Haaremy/hmyLaser32/public/papers/v1/LCD1602.jpg

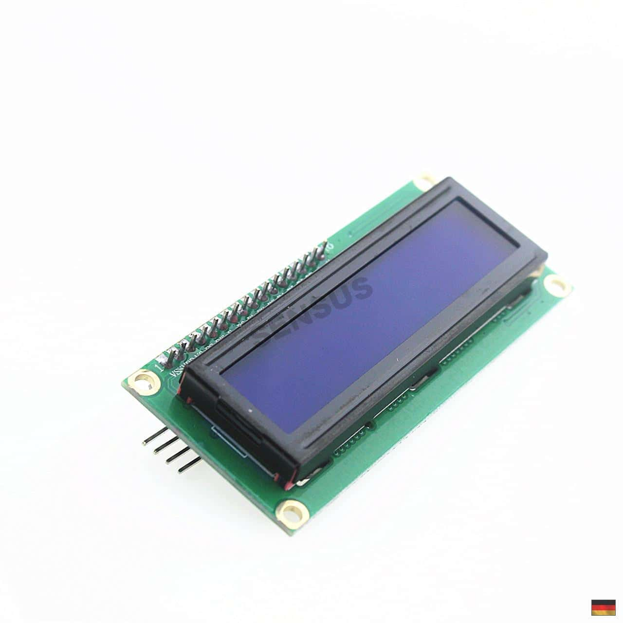
public/papers/v1/LCD1602.jpg
