Haaremy/hmyLaser32/public/papers/v1/Konzept_Pistole.jpg

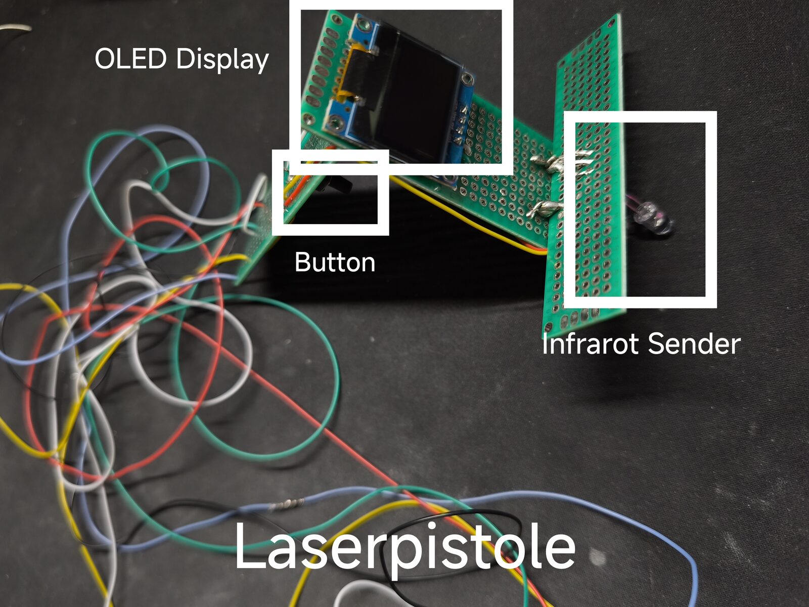
public/papers/v1/Konzept_Pistole.jpg
