Haaremy/hmyLaser32/public/papers/v1/ESP32_Dev_Board.jpg

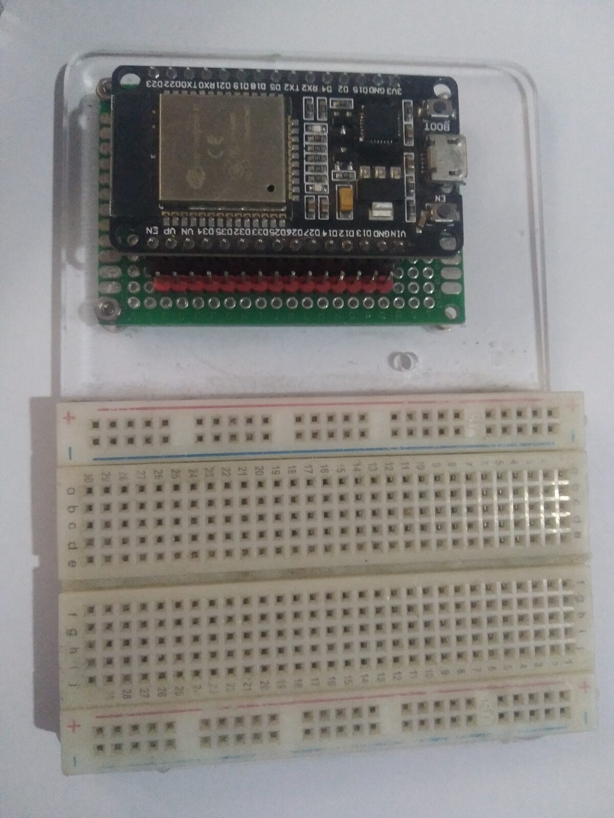
public/papers/v1/ESP32_Dev_Board.jpg
