Haaremy/hmyLaser32/public/papers/v1/Konzept-Weste.jpg

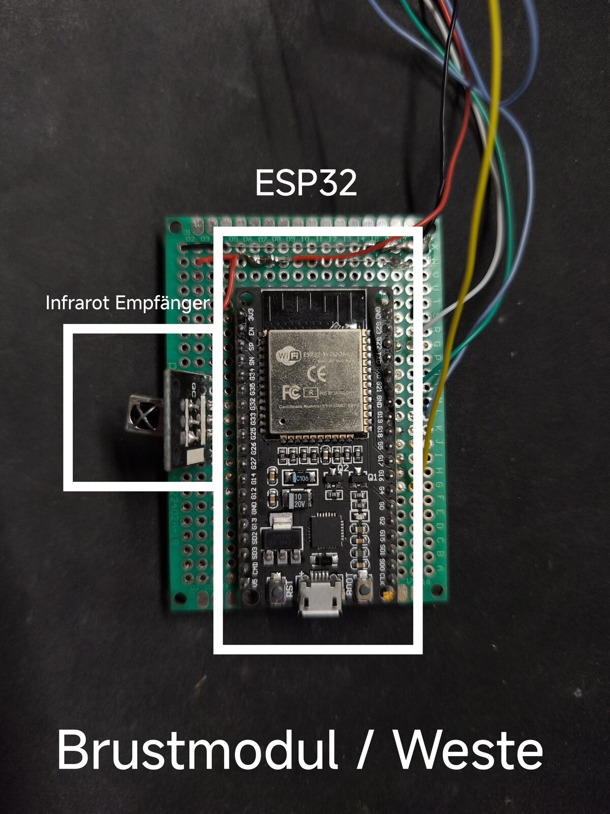
public/papers/v1/Konzept-Weste.jpg
