Haaremy/hmyLaser32/public/papers/v1/KY_Infrarot_Set.jpg

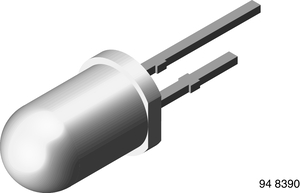
public/papers/v1/KY_Infrarot_Set.jpg
