Haaremy/hmyLaser32/public/papers/v1/TSOP38238.jpg

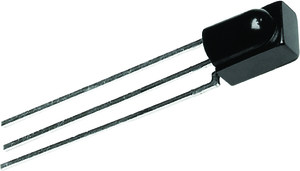
public/papers/v1/TSOP38238.jpg
