Haaremy/hmyLaser32/Arduino/lasertag_client/Game.cpp

#include "Game.h"
#include <IRutils.h>
#include <cstring>
#include "Config.h"
#include "Display.h"
#include "Globals.h"
#include "Identity.h"
#include "Led.h"
#include "LasertagNetwork.h"
#include "Ranking.h"
#include "ZoneIr.h"

uint32_t getMyPlayerId() {
  return irsend.encodeNEC(IR_GAME_ADDRESS, identityMyCommand());
}

static uint8_t reverse8(uint8_t value) {
  value = (value & 0xF0) >> 4 | (value & 0x0F) << 4;
  value = (value & 0xCC) >> 2 | (value & 0x33) << 2;
  value = (value & 0xAA) >> 1 | (value & 0x55) << 1;
  return value;
}

static uint8_t commandFromPlayerId(uint32_t playerId) {
  return reverse8((uint8_t)((playerId >> 8) & 0xFFu));
}

bool isPlayerDisabled() {
  return static_cast<long>(playerDisabledUntil - millis()) > 0;
}

unsigned long getDisableTimeLeftMs() {
  if (!isPlayerDisabled()) return 0;
  return playerDisabledUntil - millis();
}

static uint8_t effectivePhase() {
  if (g_phaseLastUpdate != 0 && (millis() - g_phaseLastUpdate) < PHASE_TIMEOUT_MS) {
    if (g_phase == PHASE_IDLE) return PHASE_ACTIVE;
    return g_phase;
  }
  if (g_standalonePhase != PHASE_IDLE) return g_standalonePhase;
  return PHASE_ACTIVE;
}

bool isShootingAllowed() {
  return effectivePhase() == PHASE_ACTIVE;
}

static uint32_t resolveShooterColor(uint32_t shooterPlayerId) {
  uint8_t cmd = commandFromPlayerId(shooterPlayerId);
  bool teamsFresh = g_teamCount > 0 && (millis() - g_teamsLastUpdate) < TEAMS_TIMEOUT_MS;
  if (teamsFresh) {
    uint32_t bit = (cmd >= 1 && cmd <= 32) ? (1u << (cmd - 1)) : 0u;
    for (uint8_t i = 0; i < g_teamCount; i++) {
      if (g_teams[i].memberBits & bit) return g_teams[i].color;
    }
  }
  if (cmd >= 1) return COLOR_POOL[(cmd - 1) % COLOR_POOL_SIZE];
  return 0xFFFFFF;
}

bool handleTrigger() {
  bool reading = digitalRead(BUTTON_PIN);

  if (reading != lastRawButtonReading) {
    lastDebounce = millis();
    lastRawButtonReading = reading;
  }

  if ((millis() - lastDebounce) > DEBOUNCE_MS && reading != lastButtonState) {
    lastButtonState = reading;

    if (reading == LOW) {
      if (isPlayerDisabled()) { updateDisplay(); return true; }
      if (!isShootingAllowed()) { updateDisplay(); return true; }
      if (!identityIsAssigned()) { updateDisplay(); return true; }

      const uint32_t myPlayerId = getMyPlayerId();
      irsend.sendNEC(static_cast<uint64_t>(myPlayerId), 32);
      lastShotAt = millis();
      shotsFired++;
      Serial.printf("[SHOT] %s sent NEC 0x%lx, shot #%d\n",
                    identityMyName(), (unsigned long)myPlayerId, shotsFired);
      broadcastPlayerState();
      updateDisplay();
    }
  }
  return true;
}

static void resetHitCounters() {
  hitCount = 0;
  hitCountPrimary = 0;
  hitCountSecondary = 0;
  hitCountTertiary = 0;
}

static int teamIndexForPlayer(uint32_t playerId) {
  uint8_t cmd = commandFromPlayerId(playerId);
  bool teamsFresh = g_teamCount > 0 && (millis() - g_teamsLastUpdate) < TEAMS_TIMEOUT_MS;
  if (!teamsFresh) return -1;
  uint32_t bit = (cmd >= 1 && cmd <= 32) ? (1u << (cmd - 1)) : 0u;
  if (!bit) return -1;
  for (uint8_t i = 0; i < g_teamCount; i++) {
    if (g_teams[i].memberBits & bit) return i;
  }
  return -1;
}

static bool isFriendlyFire(uint32_t shooterPlayerId) {
  if (strcmp(g_phaseMode, "team") != 0) return false;
  int shooterTeam = teamIndexForPlayer(shooterPlayerId);
  int myTeam = teamIndexForPlayer(getMyPlayerId());
  return shooterTeam >= 0 && myTeam >= 0 && shooterTeam == myTeam;
}

static uint16_t encodedAddressPrefix() {
  return (uint16_t)((irsend.encodeNEC(IR_GAME_ADDRESS, 0) >> 16) & 0xFFFFu);
}

static bool isValidGameNec(uint32_t raw) {
  const uint16_t addressPrefix = (uint16_t)((raw >> 16) & 0xFFFFu);
  const uint8_t encodedCommand = (uint8_t)((raw >> 8) & 0xFFu);
  const uint8_t encodedCommandInverse = (uint8_t)(raw & 0xFFu);
  return addressPrefix == encodedAddressPrefix() &&
         (uint8_t)(encodedCommand ^ encodedCommandInverse) == 0xFFu;
}

static const char *zoneName(uint8_t zone) {
  switch (zone) {
    case 1: return "ZONE1";
    case 2: return "ZONE2";
    case 3: return "ZONE3";
    default: return "ZONE?";
  }
}

static int zonePointsForFrame(const ZoneIrFrame &frame) {
  if (frame.zone >= 1 && frame.zone <= 3) return g_zonePoints[frame.zone - 1];
  return 0;
}

static bool shouldPreferFrame(const ZoneIrFrame &candidate, const ZoneIrFrame &selected) {
  const int candidatePoints = zonePointsForFrame(candidate);
  const int selectedPoints = zonePointsForFrame(selected);
  if (candidatePoints != selectedPoints) return candidatePoints > selectedPoints;
  return (int32_t)(candidate.startUs - selected.startUs) < 0;
}

static bool handleIrZoneFrame(uint32_t shooterId,
                              const char *sensorName,
                              int &sensorHitCount,
                              int zonePoints) {
  const char *shooterName = findPlayerNameById(shooterId);
  char shooterNameCopy[12] = {};
  const bool withinSelfHitWindow = millis() - lastShotAt < SELF_HIT_IGNORE_MS;
  if (shooterName) {
    strncpy(shooterNameCopy, shooterName, sizeof(shooterNameCopy) - 1);
    shooterNameCopy[sizeof(shooterNameCopy) - 1] = '\0';
  } else {
    uint8_t cmd = commandFromPlayerId(shooterId);
    snprintf(shooterNameCopy, sizeof(shooterNameCopy), "Cmd%03u", (unsigned)cmd);
  }

  if (!isValidGameNec(shooterId)) {
    Serial.printf("[IR:%s] ignored raw=0x%08lx expectedPrefix=0x%04x\n",
                  sensorName,
                  (unsigned long)shooterId,
                  (unsigned)encodedAddressPrefix());
  } else if (isPlayerDisabled()) {
    Serial.printf("[IR:%s] ignored while disabled from %s\n", sensorName, shooterNameCopy);
  } else if (!isShootingAllowed()) {
    Serial.printf("[IR:%s] ignored outside ACTIVE phase from %s\n", sensorName, shooterNameCopy);
  } else if (shooterId == getMyPlayerId() && withinSelfHitWindow) {
    Serial.printf("[IR:%s] ignored self reflection from %s\n", sensorName, shooterNameCopy);
  } else if (shooterId != getMyPlayerId() && !isFriendlyFire(shooterId)) {
    hitCount++;
    sensorHitCount++;
    playerDisabledUntil = millis() + HIT_DISABLE_MS;
    uint32_t shooterColor = resolveShooterColor(shooterId);
    triggerHitBlink(shooterColor);
    Serial.printf("[HIT:%s] from %s (color #%06lx, sensor hits %d/%d/%d, +%d)\n",
                  sensorName,
                  shooterNameCopy[0] ? shooterNameCopy : "?",
                  (unsigned long)shooterColor,
                  hitCountPrimary,
                  hitCountSecondary,
                  hitCountTertiary,
                  zonePoints);

    if (awardPointsToPlayer(shooterId, shooterNameCopy, zonePoints)) {
      queueTableBroadcast();
    }
    broadcastHitEvent(shooterId, shooterNameCopy, zonePoints);
    broadcastPlayerState();
    updateDisplay();
  }

  return true;
}

bool handleIrReceiver() {
  ZoneIrFrame frame = {};
  if (isPlayerDisabled()) {
    while (zoneIrPoll(frame)) { }
    return false;
  }

  ZoneIrFrame selected = {};
  bool hasSelected = false;
  while (zoneIrPoll(frame)) {
    if (!isValidGameNec(frame.raw)) {
      Serial.printf("[IR:%s GPIO%u] ignored raw=0x%08lx expectedPrefix=0x%04x\n",
                    zoneName(frame.zone),
                    (unsigned)frame.pin,
                    (unsigned long)frame.raw,
                    (unsigned)encodedAddressPrefix());
      continue;
    }
    Serial.printf("[IR:%s GPIO%u] candidate raw=0x%08lx t=%lu pts=%d\n",
                  zoneName(frame.zone),
                  (unsigned)frame.pin,
                  (unsigned long)frame.raw,
                  (unsigned long)frame.startUs,
                  zonePointsForFrame(frame));
    if (!hasSelected || shouldPreferFrame(frame, selected)) {
      selected = frame;
      hasSelected = true;
    }
  }

  if (!hasSelected) return false;

  if (selected.zone == 1) {
    return handleIrZoneFrame(selected.raw, "ZONE1", hitCountPrimary, g_zonePoints[0]);
  }
  if (selected.zone == 2) {
    return handleIrZoneFrame(selected.raw, "ZONE2", hitCountSecondary, g_zonePoints[1]);
  }
  if (selected.zone == 3) {
    return handleIrZoneFrame(selected.raw, "ZONE3", hitCountTertiary, g_zonePoints[2]);
  }
  return false;
}

void resetRuntimeStatsForNewMatch() {
  shotsFired = 0;
  myPoints = 0;
  resetHitCounters();
}

void updateRespawnDisplayState(bool disabledNow, bool &wasPlayerDisabled) {
  if (disabledNow) {
    if (millis() - lastDisplayRefreshAt >= 150) updateDisplay();
  } else if (wasPlayerDisabled) {
    applyTeamColor();
    updateDisplay();
  }
  wasPlayerDisabled = disabledNow;
}

// === Standalone-State-Machine (v4 + v4.1 Master-Election) ================
// Master (= niedrigste MAC unter den bekannten Peers) treibt die State-
// Machine voran. Andere Clients syncen ihre Timer per MSG_STANDALONE.
//
// Wenn länger als STANDALONE_TIMEOUT_MS keine Master-Nachricht eingegangen
// ist, übernimmt der aktuelle Knoten (sofern er Master ist) selbst die
// Initiative — oder bleibt im aktuellen Zustand bis der Master wieder da
// ist (passive Knoten).
static unsigned long kStandaloneStateChangedAt = 0;

void standaloneStateTick(int peerCountIncludingSelf) {
  bool serverActive = (g_phaseLastUpdate != 0 && (millis() - g_phaseLastUpdate) < PHASE_TIMEOUT_MS);
  if (serverActive) {
    g_standalonePhase = PHASE_IDLE;
    return;
  }
  if (!identityIsAssigned()) return;

  unsigned long now = millis();
  bool iAmMaster = identityIsLobbyMaster();
  bool masterFresh = (g_standaloneLastUpdate != 0) &&
                     (now - g_standaloneLastUpdate < STANDALONE_TIMEOUT_MS);

  // Wenn ein Master existiert und nicht ich bin → passive: warten auf
  // MSG_STANDALONE, lokale Timer werden durch handleStandalone() gesetzt.
  // Wenn der lokal aktive Phasenstand abgelaufen ist, einfach Timer-Update
  // dem Master überlassen.
  if (!iAmMaster && masterFresh) {
    // Lokal nichts ausrichten — Master treibt voran
    return;
  }

  // Ich bin Master ODER kein frischer Master da → ich entscheide
  switch (g_standalonePhase) {
    case PHASE_IDLE:
      if (peerCountIncludingSelf >= 2 && iAmMaster) {
        g_standalonePhase = PHASE_LOBBY;
        g_standaloneLobbyEnds = now + STANDALONE_LOBBY_SECONDS * 1000UL;
        kStandaloneStateChangedAt = now;
        Serial.printf("[STANDALONE] Master starts LOBBY (%lus)\n",
                      (unsigned long)STANDALONE_LOBBY_SECONDS);
        memset(ranking, 0, sizeof(ranking));
        resetRuntimeStatsForNewMatch();
        updateDisplay();
      }
      break;
    case PHASE_LOBBY:
      if ((long)(now - g_standaloneLobbyEnds) >= 0 && iAmMaster) {
        g_standalonePhase = PHASE_ACTIVE;
        g_standaloneMatchEnds = now + STANDALONE_MATCH_SECONDS * 1000UL;
        kStandaloneStateChangedAt = now;
        Serial.printf("[STANDALONE] Master moves to ACTIVE (%lus)\n",
                      (unsigned long)STANDALONE_MATCH_SECONDS);
        updateDisplay();
      }
      break;
    case PHASE_ACTIVE:
      if ((long)(now - g_standaloneMatchEnds) >= 0 && iAmMaster) {
        g_standalonePhase = PHASE_DONE;
        kStandaloneStateChangedAt = now;
        Serial.println("[STANDALONE] Master moves to DONE");
        updateDisplay();
      }
      break;
    case PHASE_DONE:
      if (now - kStandaloneStateChangedAt > 15000UL && iAmMaster) {
        g_standalonePhase = PHASE_IDLE;
        kStandaloneStateChangedAt = now;
        updateDisplay();
      }
      break;
  }
}
