Haaremy/hmyLaser32/Arduino/lasertag_client/Network.cpp

#include <WiFi.h>
#include <cstring>
#include "Config.h"
#include "Display.h"
#include "Game.h"
#include "Globals.h"
#include "Identity.h"
#include "LasertagNetwork.h"
#include "Led.h"
#include "Nfc.h"
#include "Ranking.h"

bool peerExists(const uint8_t *mac) {
  for (int i = 0; i < peerCount; i++) {
    if (memcmp(knownPeers[i], mac, 6) == 0) return true;
  }
  return false;
}

void addPeer(const uint8_t *mac) {
  if (peerExists(mac) || peerCount >= MAX_PEERS) return;
  esp_now_peer_info_t peerInfo = {};
  memcpy(peerInfo.peer_addr, mac, 6);
  peerInfo.channel = 0;
  peerInfo.encrypt = false;
  if (esp_now_add_peer(&peerInfo) == ESP_OK) {
    memcpy(knownPeers[peerCount], mac, 6);
    peerCount++;
  }
}

#if defined(ESP_ARDUINO_VERSION_MAJOR) && ESP_ARDUINO_VERSION_MAJOR >= 3
void onDataSent(const wifi_tx_info_t *info, esp_now_send_status_t status) {
  (void)info; lastSendStatus = status; sendStatusPending = true;
}
#else
void onDataSent(const uint8_t *mac_addr, esp_now_send_status_t status) {
  (void)mac_addr; lastSendStatus = status; sendStatusPending = true;
}
#endif

static void handlePhase(const Message &m) {
  if (m.playerCount < 1) return;
  uint8_t newPhase = (uint8_t)m.entries[0].playerId;
  if (newPhase > PHASE_DONE) return;
  uint8_t prevPhase = g_phase;
  g_phase = newPhase;
  g_phaseSecondsLeft = (uint32_t)(m.entries[0].points < 0 ? 0 : m.entries[0].points);
  if (m.playerCount > 1 && m.entries[1].points > 0) {
    g_zonePoints[0] = m.entries[1].points;
    g_hitPoints = g_zonePoints[0];
  }
  if (m.playerCount > 2 && m.entries[2].points > 0) {
    g_zonePoints[1] = m.entries[2].points;
  }
  if (m.playerCount > 3 && m.entries[3].points > 0) {
    g_zonePoints[2] = m.entries[3].points;
  }
  g_phaseLastUpdate = millis();
  strlcpy(g_phaseMode, m.entries[0].player, sizeof(g_phaseMode));
  if (prevPhase != newPhase) {
    if (newPhase == PHASE_LOBBY) {
      resetRuntimeStatsForNewMatch();
      memset(ranking, 0, sizeof(ranking));
      playerDisabledUntil = 0;
    }
    applyTeamColor();
    updateDisplay();
  }
}

static void handleTeams(const Message &m) {
  g_teamCount = m.playerCount > MAX_TEAMS ? MAX_TEAMS : m.playerCount;
  g_myTeamIndex = -1;
  uint8_t myCmd = identityMyCommand();
  uint32_t myBit = (myCmd >= 1 && myCmd <= 32) ? (1u << (myCmd - 1)) : 0u;
  for (uint8_t i = 0; i < g_teamCount; i++) {
    strlcpy(g_teams[i].name, m.entries[i].player, sizeof(g_teams[i].name));
    g_teams[i].color      = m.entries[i].playerId & 0x00FFFFFFu;
    g_teams[i].memberBits = m.entries[i].lastUpdate;
    if (myBit && (g_teams[i].memberBits & myBit)) g_myTeamIndex = (int8_t)i;
  }
  g_teamsLastUpdate = millis();
  applyTeamColor();
  updateDisplay();
}

// v4.1: MSG_STANDALONE vom Lobby-Master.
// entries[0].playerId   = phase
// entries[0].points     = secondsLeftInPhase
// entries[0].player     = "standalone"
// entries[0].lastUpdate = millis() (Sender-Clock)
static void handleStandalone(const Message &m, const uint8_t *srcMac) {
  if (m.playerCount < 1) return;
  uint8_t newPhase = (uint8_t)m.entries[0].playerId;
  if (newPhase > PHASE_DONE) return;
  unsigned long secsLeft = (uint32_t)(m.entries[0].points < 0 ? 0 : m.entries[0].points);
  unsigned long now = millis();

  uint8_t prevPhase = g_standalonePhase;
  g_standalonePhase = newPhase;
  g_standaloneLastUpdate = now;

  if (newPhase == PHASE_LOBBY) {
    g_standaloneLobbyEnds = now + secsLeft * 1000UL;
  } else if (newPhase == PHASE_ACTIVE) {
    g_standaloneMatchEnds = now + secsLeft * 1000UL;
  }

  if (prevPhase != newPhase) {
    Serial.printf("[STANDALONE] Synced from master: phase %u -> %u (%lu s left)\n",
                  prevPhase, newPhase, secsLeft);
    if (newPhase == PHASE_LOBBY) {
      resetRuntimeStatsForNewMatch();
      memset(ranking, 0, sizeof(ranking));
    }
    applyTeamColor();
    updateDisplay();
  }
}

static void handlePlayerConfig(const Message &m) {
  uint32_t myId = getMyPlayerId();
  uint8_t myCmd = identityMyCommand();
  for (int i = 0; i < m.playerCount && i < MAX_PLAYERS; i++) {
    const RankingEntry &e = m.entries[i];
    if (e.playerId != myId) continue;
    uint32_t color = e.lastUpdate & 0x00FFFFFFu;
    if (color != 0) {
      g_myAssignedColor = color;
      identitySetColor(color);
    }
    g_myTeamIndex = (int8_t)e.points;
    if (e.player[0] != '\0' && !nfcIsBound()) identitySetName(e.player);
    Serial.printf("[CONFIG] cmd=%u team=%d color=#%06lx name=%s\n",
                  (unsigned)myCmd, (int)g_myTeamIndex, (unsigned long)color, identityMyName());
    broadcastPlayerState();
    return;
  }
}

static bool mergeRankingEntries(const Message &m) {
  bool changed = false;
  for (int i = 0; i < m.playerCount && i < MAX_PLAYERS; i++) {
    if (m.entries[i].player[0] == '\0') continue;
    if (upsertRankingEntry(m.entries[i].playerId,
                           m.entries[i].player,
                           m.entries[i].points,
                           m.entries[i].lastUpdate)) changed = true;
  }
  if (changed) {
    syncMyPointsFromRanking();
    updateDisplay();
  }
  return changed;
}

void processIncomingMessage(const uint8_t *srcAddr, const uint8_t *data, int len) {
  if (len != sizeof(Message)) return;
  Message incoming;
  memcpy(&incoming, data, sizeof(incoming));
  addPeer(srcAddr);

  bool isServer = (incoming.msgType == MSG_PHASE || incoming.msgType == MSG_TEAMS);
  identityPeerSeen(srcAddr, isServer);

  switch (incoming.msgType) {
    case MSG_DISCOVERY:
      mergeRankingEntries(incoming);
      queueTableBroadcast();
      return;
    case MSG_PHASE:
      handlePhase(incoming);
      return;
    case MSG_TEAMS:
      handleTeams(incoming);
      return;
    case MSG_PLAYER_CONFIG:
      handlePlayerConfig(incoming);
      return;
    case MSG_STANDALONE:
      handleStandalone(incoming, srcAddr);
      return;
    case MSG_NFC:
      return;
    case MSG_TABLE: {
      if (mergeRankingEntries(incoming)) {
        queueTableBroadcast();
      }
      return;
    }
    default:
      return;
  }
}

#if defined(ESP_ARDUINO_VERSION_MAJOR) && ESP_ARDUINO_VERSION_MAJOR >= 2
void onDataRecv(const esp_now_recv_info_t *info, const uint8_t *data, int len) {
  processIncomingMessage(info->src_addr, data, len);
}
#else
void onDataRecv(const uint8_t *mac, const uint8_t *data, int len) {
  processIncomingMessage(mac, data, len);
}
#endif

void sendDiscovery() {
  const uint8_t broadcast[] = {0xFF, 0xFF, 0xFF, 0xFF, 0xFF, 0xFF};
  memset(&outgoing, 0, sizeof(outgoing));
  strncpy(outgoing.senderName, identityMyName(), sizeof(outgoing.senderName) - 1);
  outgoing.msgType = MSG_DISCOVERY;
  if (identityIsAssigned()) {
    outgoing.playerCount = 1;
    outgoing.entries[0].playerId = getMyPlayerId();
    strncpy(outgoing.entries[0].player, identityMyName(), sizeof(outgoing.entries[0].player) - 1);
    outgoing.entries[0].points = myPoints;
    outgoing.entries[0].lastUpdate = millis();
  } else {
    outgoing.playerCount = 0;
  }
  esp_now_send(broadcast, reinterpret_cast<const uint8_t *>(&outgoing), sizeof(outgoing));
}

void broadcastRankingTable() {
  const uint8_t broadcast[] = {0xFF, 0xFF, 0xFF, 0xFF, 0xFF, 0xFF};
  memset(&outgoing, 0, sizeof(outgoing));
  strncpy(outgoing.senderName, identityMyName(), sizeof(outgoing.senderName) - 1);
  outgoing.msgType = MSG_TABLE;
  for (int i = 0; i < MAX_PLAYERS; i++) {
    outgoing.entries[i] = ranking[i];
    if (ranking[i].player[0] != '\0') outgoing.playerCount++;
  }
  // Broadcast statt unicast-an-jeden — spart Bandbreite
  esp_now_send(broadcast, reinterpret_cast<const uint8_t *>(&outgoing), sizeof(outgoing));
  lastTableBroadcast = millis();
  pendingTableBroadcast = false;
}

static void copyChunk(char *dst, size_t dstLen, const char *src, int chunk) {
  if (!src || !dst || dstLen == 0) return;
  strncpy(dst, src + (chunk * 11), dstLen - 1);
  dst[dstLen - 1] = '\0';
}

void broadcastPlayerState() {
  if (!identityIsAssigned()) return;
  const uint8_t broadcast[] = {0xFF, 0xFF, 0xFF, 0xFF, 0xFF, 0xFF};
  Message m = {};
  strlcpy(m.senderName, identityMyName(), sizeof(m.senderName));
  m.msgType = MSG_PLAYER_STATE;
  m.playerCount = 6;
  m.entries[0].playerId = getMyPlayerId();
  strlcpy(m.entries[0].player, identityMyName(), sizeof(m.entries[0].player));
  m.entries[0].points = myPoints;
  m.entries[0].lastUpdate = millis();

  m.entries[1].playerId = (g_myAssignedColor ? g_myAssignedColor : identityMyColor()) & 0x00FFFFFFu;
  m.entries[1].points = (int16_t)(shotsFired > 32767 ? 32767 : shotsFired);
  m.entries[1].lastUpdate = (uint32_t)(hitCount > 65535 ? 65535 : hitCount);

  m.entries[2].points = g_myTeamIndex;
  const char *token = nfcLastToken();
  for (int i = 0; i < 4; i++) {
    copyChunk(m.entries[i + 2].player, sizeof(m.entries[i + 2].player), token, i);
  }
  esp_now_send(broadcast, reinterpret_cast<const uint8_t *>(&m), sizeof(m));
}

void broadcastHitEvent(uint32_t shooterId, const char *shooterName, int points) {
  const uint8_t broadcast[] = {0xFF, 0xFF, 0xFF, 0xFF, 0xFF, 0xFF};
  Message m = {};
  strlcpy(m.senderName, identityMyName(), sizeof(m.senderName));
  m.msgType = MSG_HIT_EVENT;
  m.playerCount = 2;
  m.entries[0].playerId = shooterId;
  strlcpy(m.entries[0].player, shooterName, sizeof(m.entries[0].player));
  m.entries[0].points = (int16_t)points;
  m.entries[0].lastUpdate = millis();
  m.entries[1].playerId = getMyPlayerId();
  strlcpy(m.entries[1].player, identityMyName(), sizeof(m.entries[1].player));
  m.entries[1].points = (int16_t)(hitCount > 32767 ? 32767 : hitCount);
  m.entries[1].lastUpdate = (uint32_t)(shotsFired > 65535 ? 65535 : shotsFired);
  esp_now_send(broadcast, reinterpret_cast<const uint8_t *>(&m), sizeof(m));
}

// v4.1 — Master broadcastet aktuelle Standalone-Phase + Restzeit
void broadcastStandaloneState() {
  if (!identityIsLobbyMaster()) return;
  if (g_standalonePhase == PHASE_IDLE) return;

  const uint8_t broadcast[] = {0xFF, 0xFF, 0xFF, 0xFF, 0xFF, 0xFF};
  Message m = {};
  strlcpy(m.senderName, identityMyName(), sizeof(m.senderName));
  m.msgType = MSG_STANDALONE;
  m.playerCount = 1;
  m.entries[0].playerId = (uint32_t)g_standalonePhase;

  unsigned long now = millis();
  long secsLeft = 0;
  if (g_standalonePhase == PHASE_LOBBY) {
    secsLeft = (long)(g_standaloneLobbyEnds - now) / 1000L;
  } else if (g_standalonePhase == PHASE_ACTIVE) {
    secsLeft = (long)(g_standaloneMatchEnds - now) / 1000L;
  }
  if (secsLeft < 0) secsLeft = 0;
  m.entries[0].points = (int16_t)(secsLeft > 32767 ? 32767 : secsLeft);
  strlcpy(m.entries[0].player, "standalone", sizeof(m.entries[0].player));
  m.entries[0].lastUpdate = now;

  esp_now_send(broadcast, reinterpret_cast<const uint8_t *>(&m), sizeof(m));
}

void handleSendStatusLog() {
  if (sendStatusPending) sendStatusPending = false;
}
