Haaremy/hmyLaser32/(commit log)

2026-05-15 Initial portal scaffold — Next.js 14 + Prisma + Bridge API
    - 14 routes: landing, wiki (hardware/architecture/build-guide/components),
    auth (login/register), profile, leaderboard, match detail, admin (users/devices/matches), game panel
    - Prisma schema: User, EspServer, Match, MatchPlayer, Team
    - Auth: argon2 + iron-session, custom (no SSO per spec)
    - ESP32 bridge: POST /api/bridge/{match/start,match/end,hit}, GET /player/:nfcToken, WS /api/bridge/ws
    - i18n DE/EN via next-intl with cookie locale switch
    - hmyDesign tokens v1.0.0 inlined as CSS variables
    - /api/health endpoint, /api/matches/export (CSV/JSON)
    - Footer with legal.haaremy.de/impressum + datenschutz (Haaremy compliance)
    - Docker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
2026-05-15 Pivot v2: ESP self-register + live match view + wiki from paper
    Architecture pivot per CEO feedback:
    ESP self-registration
    - POST /api/bridge/register: ESP generates name+PIN locally and registers itself.
    Returns 201 on first register, 200 on re-register (same name+PIN), 409 on conflict.
    - Bridge auth and match-settings unlock both use the same PIN (single secret per device).
    - Admin device management removed (no admin gate anymore).
    Schema changes
    - EspServer.accessCode → pin (renamed, single source of truth)
    - EspServer.online: bool, EspServer.name unique
    - Match.settings: Json (per-match config)
    - MatchPlayer.shotsFired: int (for accuracy calc)
    - HitEvent model: persisted live-feed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
2026-05-15 Added Arduino Code
    Open lasertag_main
    Edit Settings, especially inbetween devices.
    On Device Upload
    Upload Speed 115200
    Erase all Flash true
    Upload Frequence 40Mhz
2026-05-15 ESPCode und Latex
2026-05-16 v3: ESP-Server firmware (modular) + Wiki restructure + Latex sources restored
    ESP-Server (Arduino/lasertag_server/)
    - New modular Arduino sketch for the bridge ESP32 NodeMCU-32S
    - Modules: Bridge, Config, EspNow, Globals, Identity, Match, Portal, Storage,
    Types, WiFiSetup + lasertag_server.ino (1182 lines total)
    - Self-generated Name+PIN persisted in NVS (Preferences lib)
    - Captive Portal on first boot: WLAN scan, secure list, click-to-select,
    saves SSID+PSK and reboots into STA mode
    - HTTP bridge to laser32.haaremy.de: auto-register on boot, heartbeat
    every 30s, match-start/end orchestration with lobby timer
    - ESP-NOW listener with score-diff detection forwards hits during ACTIVE
    ma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
    [Bridge.cpp, Bridge.h, Config.h, Display.cpp, EspNow.cpp, EspNow.h, Game.cpp]
2026-05-16 v4: hmyDesign overhaul + new IA (Forschung/DIY/Account/Champions)
    Design system
    - Adopt hmyDesign token CSS verbatim (public/hmy/tokens.css)
    - All component classes now use hmy-* BEM-style naming from
    /opt/hmyDesign/components.md: .hmy-btn, .hmy-card, .hmy-tabs,
    .hmy-input, .hmy-alert, .hmy-field
    - Lasertag-specific classes prefixed .hmy-lt-* for clear separation
    - Match view, ESP detail, champions, research, DIY all migrated
    Information architecture overhaul
    - Landing page reduced to ESP server list only (no more quicklinks)
    - Navbar: Server / Forschung / DIY / Champions / Account
    - /research: index card with each paper; download + read-online side-by-side
    - /research/paper-v1: full we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
2026-05-16 v5: server keeps AP permanently + mDNS + phase-aware client + ESP settings via web
    Pain points addressed
    - ESP-server hotspot vanished after STA connect: switched to AP+STA dual-mode
    permanently. Captive portal stays reachable at http://192.168.4.1 even
    after the device joined the home WiFi. mDNS publishes
    http://hmylaser32-<name>.local as a second access path.
    - Web service was missing ESP-side controls: added a Settings tab on
    /esp/[id] with PIN-gated mode/lobby/match editing and a Match-jetzt-
    starten button. The button sets a startRequested flag in the DB; the ESP
    pulls /api/esp/by-pin/settings every 30 s and consumes the flag atomically.
    - Client had no awareness of the new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
    [Bridge.cpp, Bridge.h, Config.h, Display.cpp, EspNow.cpp, EspNow.h, Game.cpp, Game.h]
2026-05-16 v6: team mode + 24h offline cleanup
    Web service
    - Schema: EspServer.teams Json — array of {name, color, members[]}
    - /api/servers cleans up ESPs that have been offline >24 h (deleteMany on
    lastSeen<cutoff or NULL+createdAt<cutoff).
    - /api/esp/[id]/settings accepts mode enum ("free-for-all" | "team") and
    teams[] payload via zod schema (lib/teams.ts).
    - /api/esp/by-pin/settings includes parsed teams in the pull response.
    - /esp/[id] Settings tab: mode dropdown, dynamic team editor with color
    picker, name, member CSV (MY_IR_COMMAND 1..254). Labels renamed:
    Lobby-Sekunden → Starttimer, Match-Sekunden → Runden-Dauer,
    "Match jetzt starten" → "▶ Timer starten".
    ESP server firmw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
2026-05-16 v7: known-clients push + assign-by-dropdown team editor
    ESP-Server firmware
    - New POST /api/bridge/players sent every 30 s with the current
    g_snapshots[] (name + NEC command + playerId + points + lastSeen).
    - bridgePushKnownPlayers extracts the NEC command byte from the 32-bit
    playerId (bits 8..15) so the web UI can match it to MY_IR_COMMAND.
    - Designated-initializer for g_settings (mode/lobby/match + zero teams).
    - README banner updated to v3.
    - Schema: EspServer.knownPlayers Json (list of {name, command, playerId,
    points, lastSeenSec}).
    - /api/bridge/players (Bearer=PIN) persists the snapshot.
    - /api/esp/[id]/players (public GET) returns the snapshot.
    - lib/players.ts sc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
2026-05-16 v8: WebSockets + auto-identity + hit-effect + NFC stubs
    - server.mjs: new WebSocket endpoints
    /api/ws/match/<id> — Browser live state (snapshot push every 1 s while
    there are subscribers; instant push on /api/bridge/hit POST)
    /api/ws/esp/<id> — Browser ESP detail (live snapshot + bi-directional
    write channel: updateSettings / startMatch via WS, PIN-gated)
    - globalThis.wsHub.broadcastMatch/broadcastEsp called from hit/players/
    settings/start API routes so DB mutations push to subscribers immediately.
    - HitEvent persistence now also upserts MatchPlayer aggregates if the bridge
    passes shooterHits/shooterDeaths/shooterShots in the body.
    Browser
    - /match/[id]: r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
2026-05-16 fix(client): Ranking.cpp uses identityMyName() (MY_NAME removed in v4)
    Compile error after the v4 auto-identity refactor:
    Ranking.cpp:94 'MY_NAME' was not declared in this scope
    In v4 MY_NAME was removed from Config.h in favour of the runtime
    identity (Identity.cpp). updateMyScore() still referenced the old
    constant. Now uses identityMyName() and adds the corresponding
    Identity.h include.
    [Ranking.cpp]
2026-05-16 v4.1 client: fix all-Alpha bug, button back to GPIO 19, master-election
    Bugs reported by user with 3 clients in standalone mode:
    - all three displayed as "Alpha" (rank -1)
    - 4th joining client got full 60 s lobby while others were already active
    - button moved from GPIO 19 → 32 without consent
    Fixes
    - BUTTON_PIN reverted to GPIO 19 (matches Paper V1 hardware). NFC pin
    conflict is now only a Wiki recommendation (BUTTON → 32, HAS_NFC=1).
    - Discovery rate accelerated to 1 s for the first 15 s after boot
    (instead of 5 s); falls back to 5 s afterwards. This drastically
    reduces the chance of a client assigning identity before all peers
    have been seen.
    - IDENTITY_WAIT_MS raised 3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
    [Config.h, Game.cpp, Globals.h, Identity.cpp, Identity.h, Network.cpp, lasertag_client.ino]
2026-05-16 DIY wiki: real product links from V1 build + MFRC522 NFC entry
    Bezugsquellen für den V1-Prototyp ergänzt (vom Autor tatsächlich
    verwendete Amazon/TME-Links):
    - ESP32 NodeMCU-32S → amazon.de/dp/B0D8635YZ6
    - TSOP38238 IR-Empfänger → tme.eu (Original-Vishay-Distributor)
    - KY-005 IR-Sender → amazon.de/dp/B0F9L3SZ97
    - SSD1306 OLED → amazon.de/dp/B01L9GC470
    - Taster → amazon.de/dp/B07XWYHPZH
    - 5 mm RGB-LEDs (gem. Kathode) → amazon.de/dp/B0897LDR9N
    - Taktische Weste (Trägermaterial) → amazon.de/dp/B0F6Y2MSXN
    Zusätzlich:
    - MFRC522 als optionale Komponente mit Hinweis auf BUTTON_PIN-Verlegung
    von 19 → 32 wenn NFC aktiviert wird.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
2026-05-16 v4.2: WS2812B strip support + button default 32 + docs updated
    Firmware changes (Arduino/lasertag_client/)
    - Led.cpp uses FastLED when USE_WS2812=1 (default). All LEDs in the
    strip are set in unison: team color / identity color / hit-blink
    shooter color. fill_solid + FastLED.show on every change. Brightness
    capped at LED_BRIGHTNESS=80/255 to stay within powerbank budget.
    - Legacy 3-pin RGB LED mode preserved via #define USE_WS2812 0
    (gates the pinMode + analogWrite path in lasertag_client.ino and
    Led.cpp).
    - BUTTON_PIN default changed back to GPIO 32 per user request. NFC
    remains optional; comments document GPIO 19 as the alternative when
    the MFRC522 isn't fitted.
    - Config.h ad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
2026-05-16 Config.h: QUICK-CONFIG block at the top — LED mode, strip count, NFC
    User asked for the LED-vs-strip toggle to live in the config. It already
    did, but was buried between pin definitions. This commit reorganises
    Config.h so the four "every-build" switches are at the very top in a
    clearly marked QUICK-CONFIG section:
    #define USE_WS2812 1
    #define LED_STRIP_COUNT 30
    #define HAS_NFC 0
    #define LED_BRIGHTNESS 80
    Everything else (pin numbers, timings, message-type IDs, lobby
    durations) stays as constexpr below in the seldom-touched part.
    Doc updates
    - /diy step "Werkstatt vorbereiten" now lists FastLED + MFRC522 as
    required libraries and shows the QUICK-CONFI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
2026-06-11 feat(nfc): add writer flow and copy-ready account token
